Stefan-Olt/MISRC/hardware/kicad/v1.5/misrc_v1.5.kicad_pcb

## KiCad design hardware/kicad/v1.5/misrc_v1.5.kicad_pcb (2025-03-07)

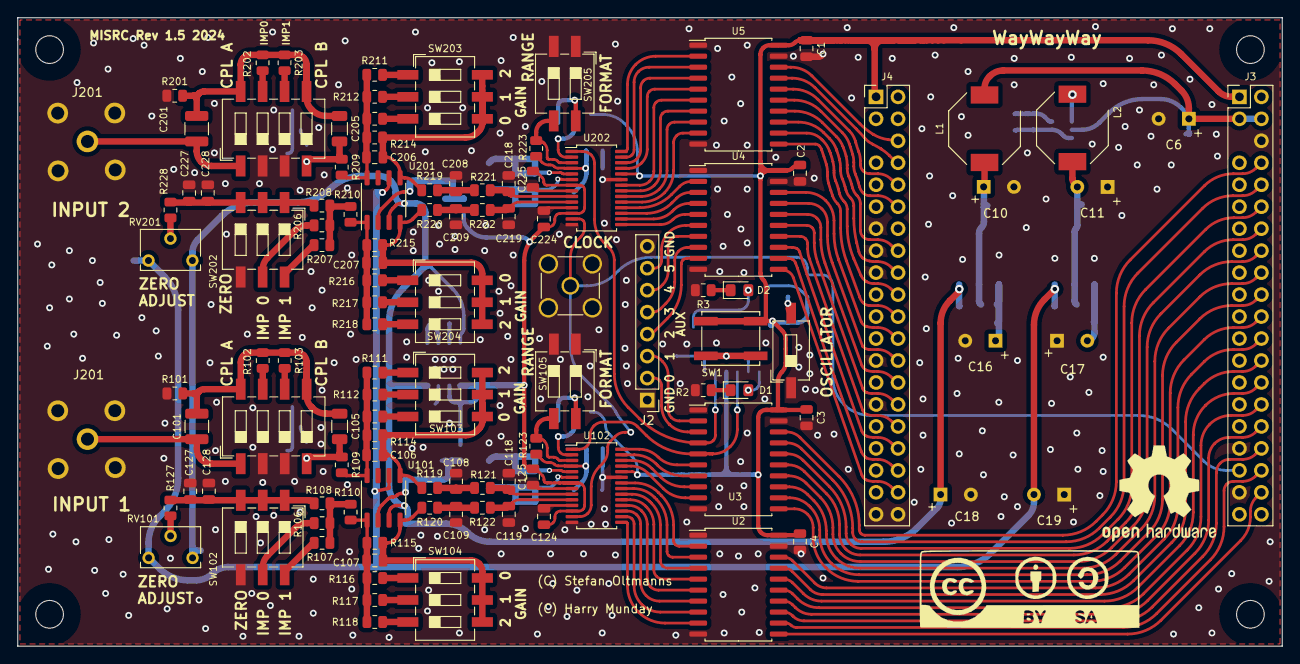
[picture p4: board misrc_v1.5.kicad_pcb from above]

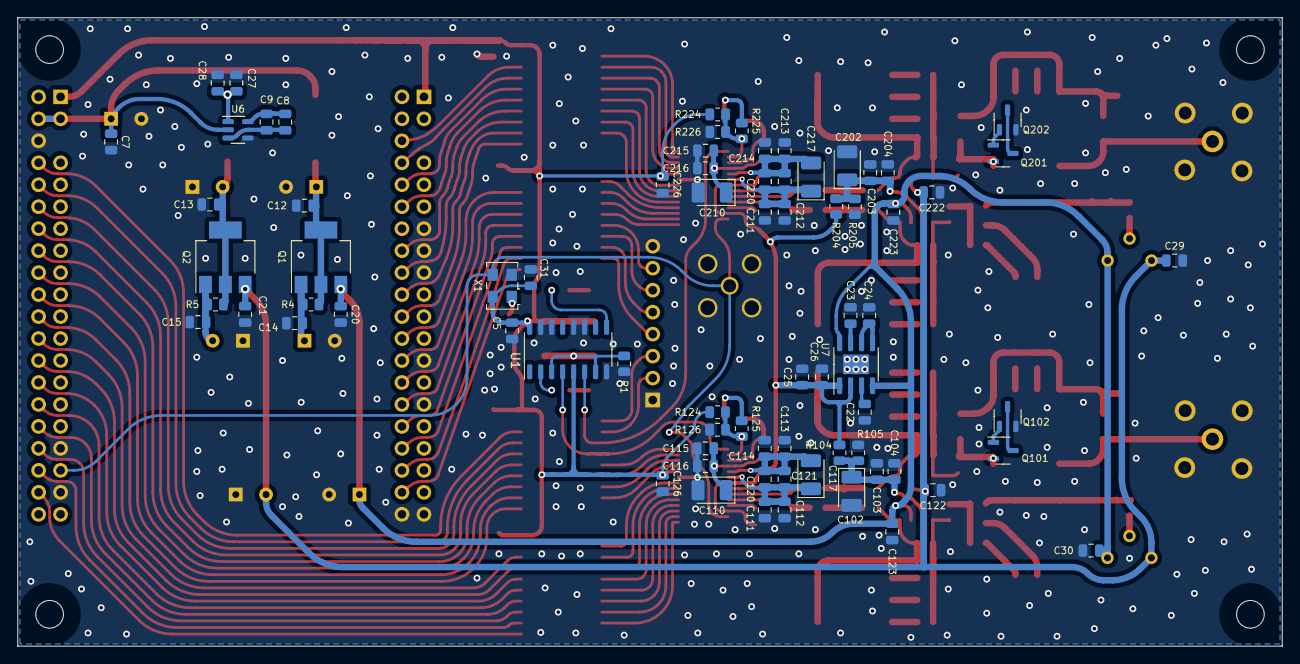
[picture p5: board misrc_v1.5.kicad_pcb from below]

Board: 2 copper layers, 146.2 x 72.6 mm, 192 parts (75 on the bottom side), 153 nets.

Parts:
C1, C2, C3, C4, C5, C7, C12, C13, C20, C21, C22, C23, C24, C29, C30, C31: 1µ; C_0805_2012Metric
C6, C11, C16, C19: 470µ; CP_Radial_FlatB_D8.0mm_P3.50mm
C8, C25, C28, C127, C227: 10µ; C_0805_2012Metric
C9, C14, C15, C26, C103, C112, C113, C115, C120, C122, C123, C124, C125, C126, C203, C212, C213, C215, C220, C222, C223, C224, C225, C226: 100n; C_0805_2012Metric
C10, C17, C18: 470µ; CP_Radial_Flat_D8.0mm_P3.50mm
C27, C104, C111, C114, C116, C121, C128, C204, C211, C214, C216, C221, C228: 1n; C_0805_2012Metric
C101, C201: 100µ; C_1210_3225Metric
C102, C110, C117, C202, C210, C217: 10µ; CP_EIA-3528-21_Kemet-B_Pad1.50x2.35mm_HandSolder
C105, C205: 470n; C_1206_3216Metric
C106, C107, C206, C207: 1p; C_0805_2012Metric
C108, C109, C208, C209: 82p; C_0805_2012Metric
C118, C119, C218, C219: 15p; C_0805_2012Metric
D1, D2: LED; LED_0805_2012Metric_Pad1.15x1.40mm_HandSolder
H1, H2, H3, H4: MountingHole; MountingHole_3.2mm_M3
J1: Conn_01x01_Shielded; SMA_Amphenol_901-144_Vertical
J2: Conn_01x08_Socket; PinHeader_1x08_P2.54mm_Vertical
J3: GPIFII_J6; PinHeader_2x20_P2.54mm_Vertical
J4: GPIFII_J7; PinHeader_2x20_P2.54mm_Vertical
J201, J201#2: DOSIN-801-0050; BNC_Right_Angle-DOSIN-801-0050
L1, L2: 100µ; L_Bourns-SRU8043
Q1: FZT690B; SOT-223-3_TabPin2
Q2: FZT790A; SOT-223-3_TabPin2
Q101, Q102, Q201, Q202: CMPT5179; SOT-23-3
R1, R123, R126, R223, R226: 10k; R_0805_2012Metric
R2, R3: 100; R_0805_2012Metric
R4, R5, R104, R105, R111, R118, R204, R205, R211, R218: 1k; R_0805_2012Metric
R101, R102, R107, R201, R202, R207: 75; R_0805_2012Metric
R103, R203: 150; R_0805_2012Metric
R106, R108, R206, R208: 39; R_0805_2012Metric
R109, R110, R209, R210: 499; R_0805_2012Metric
R112, R117, R212, R217: 2k49; R_0805_2012Metric
R113, R116, R124, R213, R216, R224: 4k99; R_0805_2012Metric
R114, R115, R214, R215: 6k49; R_0805_2012Metric
R119, R120, R219, R220: 40; R_0805_2012Metric
R121, R122, R221, R222: 22; R_0805_2012Metric
R125, R127, R225, R228: 3k3; R_0805_2012Metric
RV101, RV201: 10k; Potentiometer_Bourns_3266W_Vertical
SW1: SW_Push; SW_SPST_EVQP0
SW2: SW_DIP_x01; SW_DIP_SPSTx01_Slide_6.7x4.1mm_W8.61mm_P2.54mm_LowProfile
SW101, SW201: SW_DIP_x04; SW_DIP_SPSTx04_Slide_6.7x11.72mm_W8.61mm_P2.54mm_LowProfile
SW102, SW103, SW104, SW202, SW203, SW204: SW_DIP_x03; SW_DIP_SPSTx03_Slide_6.7x9.18mm_W8.61mm_P2.54mm_LowProfile
SW105, SW205: SW_DIP_x02; SW_DIP_SPSTx02_Slide_6.7x6.64mm_W8.61mm_P2.54mm_LowProfile
U1: 4043; SO-16_3.9x9.9mm_P1.27mm
U2, U3, U4, U5: 74VHC541; SOIC-20W_7.5x12.8mm_P1.27mm
U6: TPS60401; SOT-23-5
U7: ADP7156ARDZ; SOIC-8-1EP_3.9x4.9mm_P1.27mm_EP2.29x3mm
U101, U201: AD8138ARZ; SO-8_3.9x4.9mm_P1.27mm
U102, U202: AD9235; TSSOP-28_4.4x9.7mm_P0.65mm
X1: 40M; Oscillator_SMD_EuroQuartz_XO53-4Pin_5.0x3.2mm

Connections:
+5V: C6.1, C7.1, J3.3 (USB3_VBUS), J3.4 (USB3_VBUS), L1.1, U6.2 (VIN)
+5VA: C18.1, C20.1, C30.1, C123.1, C223.1, Q1.3 (E), RV101.3, RV201.3, U7.4 (EN), U7.8 (VIN), U101.3 (V+), U201.3 (V+)
-5VA: C19.2, C21.1, C29.1, C122.2, C222.2, Q2.3 (E), RV101.1, RV201.1, U101.6 (V-), U201.6 (V-)
/DA0: U2.9 (A7), U102.15 (Bit_0_(LSB))
/DA1: U2.8 (A6), U102.16 (Bit_1)
/DA2: U2.7 (A5), U102.17 (Bit_2)
/DA3: U2.6 (A4), U102.18 (Bit_3)
/DA4: U2.5 (A3), U102.19 (Bit_4)
/DA5: U2.4 (A2), U102.20 (Bit_5)
/DA6: U2.3 (A1), U102.21 (Bit_6)
/DA7: U2.2 (A0), U102.22 (Bit_7)
/DA8: U3.9 (A7), U102.25 (Bit_8)
/DA9: U3.8 (A6), U102.26 (Bit_9)
/DA10: U3.7 (A5), U102.27 (Bit_10)
/DA11: U3.6 (A4), U102.28 (Bit_11_(MSB))
/DB0: U4.5 (A3), U202.15 (Bit_0_(LSB))
/DB1: U4.4 (A2), U202.16 (Bit_1)
/DB2: U4.3 (A1), U202.17 (Bit_2)
/DB3: U4.2 (A0), U202.18 (Bit_3)
/DB4: U5.9 (A7), U202.19 (Bit_4)
/DB5: U5.8 (A6), U202.20 (Bit_5)
/DB6: U5.7 (A5), U202.21 (Bit_6)
/DB7: U5.6 (A4), U202.22 (Bit_7)
/DB8: U5.5 (A3), U202.25 (Bit_8)
/DB9: U5.4 (A2), U202.26 (Bit_9)
/DB10: U5.3 (A1), U202.27 (Bit_10)
/DB11: U5.2 (A0), U202.28 (Bit_11_(MSB))
/Input_ADC_CH1/CLK: J1.1, J3.35 (PCLK), U102.13 (CLK), U202.13 (CLK), X1.3 (OUT)
/OTRA: U1.4 (S), U3.5 (A3), U102.1 (OTR)
/OTRB: U1.6 (S), U3.4 (A2), U202.1 (OTR)
GND: C1.2, C2.2, C3.2, C4.2, C5.2, C6.2, C7.2, C10.2, C11.1, C12.2, C13.2, C14.2, C15.2, C16.2, C17.1, C18.2, C19.1, C20.2, C21.2, C22.1, C23.1, C24.2, C25.2, C26.2, C27.1, C28.1, C29.2, C30.2, C31.2, C102.2, C103.2, C104.2, C108.1, C109.2, C110.2, C111.1, C112.1, C113.1, C114.1, C115.2, C116.2, C118.1, C119.2, C122.1, C123.2, C124.2, C125.2, C126.2, C127.2, C128.2, C202.2, C203.2, C204.2, C208.1, C209.2, C210.2, C211.1, C212.1, C213.1, C214.1, C215.2, C216.2, C218.1, C219.2, C222.1, C223.2, C224.2, C225.2, C226.2, C227.2, C228.2, J1.2 (Shield), J2.1, J2.8, J3.6 (GND), J3.33 (GND), J3.37 (GND), J4.13 (GND), J4.15 (GND), J4.17 (GND), J4.25 (GND), J4.29 (GND), J4.39 (GND), J4.40 (GND), J201.2, J201.3, J201.4, J201.5, J201#2.2, J201#2.3, J201#2.4, J201#2.5, Q102.2 (E), Q202.2 (E), R1.1, R2.2, R3.2, R101.1, R105.1, R126.1, R201.1, R205.1, R226.1, SW2.1, SW101.2, SW101.3, SW102.4, SW105.1, SW105.2, SW201.2, SW201.3, SW202.4, SW205.1, SW205.2, U1.8 (VSS), U1.11 (R), U1.12 (S), U1.14 (S), U1.15 (R), U2.1 (G1), U2.10 (GND), U2.19 (G2), U3.1 (G1), U3.10 (GND), U3.19 (G2), U4.1 (G1), U4.10 (GND), U4.19 (G2), U5.1 (G1), U5.10 (GND), U5.19 (G2), U6.4 (GND), U7.9 (GND), U102.8 (AGND), U102.11 (AGND), U102.14 (PWDN), U102.23 (DGND), U202.8 (AGND), U202.11 (AGND), U202.14 (PWDN), U202.23 (DGND), X1.2 (GND)
unnamed: C101.2, C105.1, R101.2, R102.2, R103.2, SW101.5, SW101.8
unnamed: C106.2, R114.2, R119.1, SW103.4, SW103.5, SW103.6, U101.5
unnamed: C107.2, R115.2, R120.1, SW104.4, SW104.5, SW104.6, U101.4
unnamed: C108.2, R119.2, R121.1
unnamed: C109.1, R120.2, R122.1
unnamed: C127.1, C128.1, R108.2, R127.1, SW102.1, SW102.2, SW102.3
unnamed: C201.2, C205.1, R201.2, R202.2, R203.2, SW201.5, SW201.8
unnamed: C206.2, R214.2, R219.1, SW203.4, SW203.5, SW203.6, U201.5
unnamed: C207.2, R215.2, R220.1, SW204.4, SW204.5, SW204.6, U201.4
unnamed: C208.2, R219.2, R221.1
unnamed: C209.1, R220.2, R222.1
unnamed: C227.1, C228.1, R208.2, R228.1, SW202.1, SW202.2, SW202.3
unnamed: D1.2 (A), U1.2 (Q)
unnamed: D1.1 (K), R2.1
unnamed: D2.2 (A), U1.9 (Q)
unnamed: D2.1 (K), R3.1
unnamed: J2.2, U3.3 (A1)
unnamed: J2.3, U3.2 (A0)
unnamed: J2.4, U4.9 (A7)
unnamed: J2.5, U4.8 (A6)
unnamed: J2.6, U4.7 (A5)
unnamed: J2.7, U4.6 (A4)
unnamed: J3.38 (DQ0), U2.11 (Y7)
unnamed: J3.36 (DQ1), U2.12 (Y6)
unnamed: J3.34 (DQ2), U2.13 (Y5)
unnamed: J3.32 (DQ3), U2.14 (Y4)
unnamed: J3.30 (DQ4), U2.15 (Y3)
unnamed: J3.28 (DQ5), U2.16 (Y2)
unnamed: J3.26 (DQ6), U2.17 (Y1)
unnamed: J3.24 (DQ7), U2.18 (Y0)
unnamed: J3.22 (DQ8), U3.11 (Y7)
unnamed: J3.20 (DQ9), U3.12 (Y6)
unnamed: J3.18 (DQ10), U3.13 (Y5)
unnamed: J3.16 (DQ11), U3.14 (Y4)
unnamed: J3.14 (DQ12), U3.15 (Y3)
unnamed: J3.12 (DQ13), U3.16 (Y2)
unnamed: J3.10 (DQ14), U3.17 (Y1)
unnamed: J3.8 (DQ15), U3.18 (Y0)
unnamed: J4.38 (DQ16), U4.11 (Y7)
unnamed: J4.36 (DQ17), U4.12 (Y6)
unnamed: J4.34 (DQ18), U4.13 (Y5)
unnamed: J4.32 (DQ19), U4.14 (Y4)
unnamed: J4.30 (DQ20), U4.15 (Y3)
unnamed: J4.28 (DQ21), U4.16 (Y2)
unnamed: J4.26 (DQ22), U4.17 (Y1)
unnamed: J4.24 (DQ23), U4.18 (Y0)
unnamed: J4.22 (DQ24), U5.11 (Y7)
unnamed: J4.20 (DQ25), U5.12 (Y6)
unnamed: J4.18 (DQ26), U5.13 (Y5)
unnamed: J4.16 (DQ27), U5.14 (Y4)
unnamed: J4.12 (DQ28), U5.15 (Y3)
unnamed: J4.10 (DQ29), U5.16 (Y2)
unnamed: J4.8 (DQ30), U5.17 (Y1)
unnamed: J4.6 (DQ31), U5.18 (Y0)
unnamed: C101.1, J201#2.1, SW101.1
unnamed: C201.1, J201.1, SW201.1
unnamed: C14.1, C16.1, Q1.1 (B), R4.2
unnamed: C10.1, C12.1, L1.2, Q1.2 (C), R4.1
unnamed: C15.1, C17.2, Q2.1 (B), R5.2
unnamed: C11.2, C13.1, L2.2, Q2.2 (C), R5.1
unnamed: Q101.1 (B), Q102.1 (B)
unnamed: Q101.3 (C), Q102.3 (C)
unnamed: C105.2, Q101.2 (E), R109.1, SW101.4
unnamed: Q201.1 (B), Q202.1 (B)
unnamed: Q201.3 (C), Q202.3 (C)
unnamed: C205.2, Q201.2 (E), R209.1, SW201.4
unnamed: R102.1, SW101.7
unnamed: R103.1, SW101.6
unnamed: R106.1, R107.1, R108.1, R110.1
unnamed: R106.2, SW102.5
unnamed: R107.2, SW102.6
unnamed: R111.2, SW103.1
unnamed: R112.2, SW103.2
unnamed: R113.2, SW103.3
unnamed: R116.2, SW104.1
unnamed: R117.2, SW104.2
unnamed: R118.2, SW104.3
unnamed: R125.1, SW105.4
unnamed: R127.2, RV101.2
unnamed: R202.1, SW201.7
unnamed: R203.1, SW201.6
unnamed: R206.1, R207.1, R208.1, R210.1
unnamed: R206.2, SW202.5
unnamed: R207.2, SW202.6
unnamed: R211.2, SW203.1
unnamed: R212.2, SW203.2
unnamed: R213.2, SW203.3
unnamed: R216.2, SW204.1
unnamed: R217.2, SW204.2
unnamed: R218.2, SW204.3
unnamed: R225.1, SW205.4
unnamed: R228.2, RV201.2
unnamed: R1.2, SW1.1, U1.3 (R), U1.7 (R)
unnamed: C8.1, C9.1, U6.5 (CP+)
unnamed: C8.2, C9.2, U6.3 (CP-)
unnamed: C27.2, C28.2, L2.1, U6.1 (VOUT)
unnamed: C22.2, U7.3 (BYP)
unnamed: C24.1, U7.5 (REF_SENSE), U7.6 (REF)
unnamed: C23.2, U7.7 (VREG)
unnamed: C106.1, R109.2, R111.1, R112.1, R113.1, R114.1, U101.8 (+)
unnamed: C107.1, R110.2, R115.1, R116.1, R117.1, R118.1, U101.1 (-)
unnamed: C102.1, C103.1, C104.1, R104.1, R105.2, U101.2 (VCM)
unnamed: C118.2, R121.2, U102.9 (IN)
unnamed: R124.2, R125.2, R126.2, U102.2 (MODE)
unnamed: C113.2, C114.2, C117.2, C120.2, C121.2, U102.5 (REFB)
unnamed: C111.2, C112.2, C117.1, C120.1, C121.1, U102.6 (REFT)
unnamed: R123.2, SW105.3, U102.3 (SENSE)
unnamed: C110.1, C115.1, C116.1, R123.1, U102.4 (VREF)
unnamed: C119.1, R122.2, U102.10 (~IN)
unnamed: C206.1, R209.2, R211.1, R212.1, R213.1, R214.1, U201.8 (+)
unnamed: C207.1, R210.2, R215.1, R216.1, R217.1, R218.1, U201.1 (-)
unnamed: C202.1, C203.1, C204.1, R204.1, R205.2, U201.2 (VCM)
unnamed: C218.2, R221.2, U202.9 (IN)
unnamed: R224.2, R225.2, R226.2, U202.2 (MODE)
unnamed: C213.2, C214.2, C217.2, C220.2, C221.2, U202.5 (REFB)
unnamed: C211.2, C212.2, C217.1, C220.1, C221.1, U202.6 (REFT)
unnamed: R223.2, SW205.3, U202.3 (SENSE)
unnamed: C210.1, C215.1, C216.1, R223.1, U202.4 (VREF)
unnamed: C219.1, R222.2, U202.10 (~IN)
unnamed: SW2.2, X1.1 (EN)
VDD: C1.1, C2.1, C3.1, C4.1, C5.1, C31.1, C126.1, C226.1, J3.1 (V3P3), J4.1 (V3P3), R124.1, R224.1, SW1.2, U1.5 (E), U1.16 (VDD), U2.20 (VCC), U3.20 (VCC), U4.20 (VCC), U5.20 (VCC), U102.24 (DRVDD), U202.24 (DRVDD), X1.4 (V+)
VDDA: C25.1, C26.1, C124.1, C125.1, C224.1, C225.1, R104.2, R204.2, U7.1 (VOUT), U7.2 (SENSE), U102.7 (AVDD), U102.12 (AVDD), U202.7 (AVDD), U202.12 (AVDD)
